kalteclabs/fg-falcon-carplay-unit/README.md

KALTEC · FG FALCON CARPLAY UNIT

### A CarPlay screen in your FG or FGX FALCON, in about 10 minutes. Pull out the tissue box, clip in the bracket, add any single-DIN head unit to your centre console!
**Jump to:** [FREE BRACKET FILE](#download-the-bracket) · [GET STARTED](#get-started) · [KITS](#kits)

---

<p align="center">
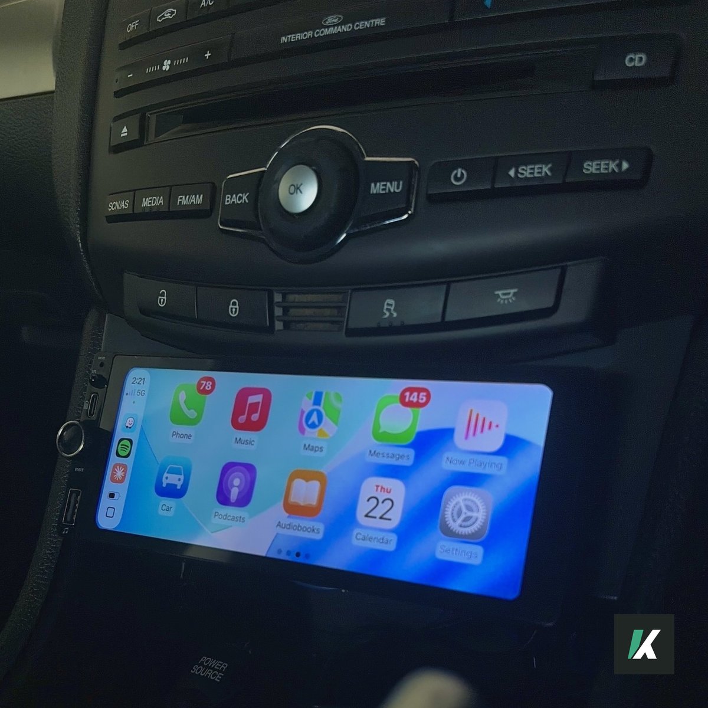
[picture p1: images/fg-installed.jpg]
CarPlay head unit fitted in the FG Falcon tissue box slot
  
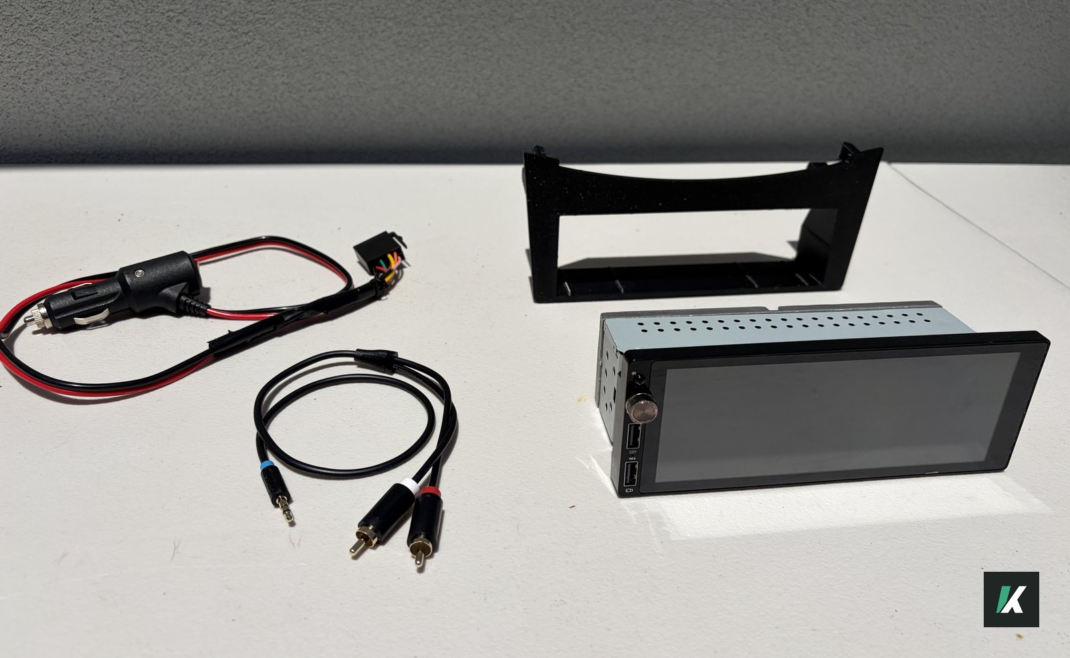
[picture p2: images/kit-parts-cig.jpg]
Head unit, bracket, cigarette plug lead and RCA cable
  
</p>

<p align="center"></p>

The CarPlay head unit takes the place of the tissue box under your factory stereo. The factory stereo stays, and the sound plays through your Falcon's own speakers via the AUX. **No splicing or cutting into any of your car's wiring!**

The parts cost about **A$65–75**, most of that being the head unit. The bracket print file is **free** from KALTEC, and the full install guide and parts list are open source too.

It's easy to remove, and the bracket can be used for an additional radio instead, if you're running aftermarket speakers or a subwoofer.

> [!TIP]
> Don't want to build it? KALTEC kits come with everything ready to plug in. Preorder a KALTEC kit for A$100: [kalteclabs@gmail.com](mailto:kalteclabs@gmail.com).

---

## DOWNLOAD THE BRACKET

<p align="center">
  
  
  
</p>

The bracket replaces your tissue box and holds any single-DIN head unit. No screws: it clips in with the two plastic clips off the tissue box. The print file is free, in three formats:

| Where | What you get | Best for |
| --- | --- | --- |
| **MakerWorld** | Print profile with the settings below | Bambu Lab printers, print straight from Bambu Studio or Handy |
| **Printables** | STL | Any printer and slicer |
| **GitHub** | STL, 3MF and STEP | Every file, including the STEP for changing the design |

**Printing it:** PETG or ASA, never PLA (it sags in a hot car). 0.2 mm layers, 4 walls, 5 top and bottom layers, 40% gyroid infill, no supports, front face down. About 3 hours and 89 g of PETG on a Bambu Lab H2S.

**[Free bracket page →](free-bracket.md)** for the full print settings, PETG vs ASA, and fitting tips.

---

## GET STARTED

1. **[Install guide](install-guide.md):** step-by-step guide to build it yourself. Pick how you'd like to power the unit:

| | Cigarette lighter | Fuse box |
| --- | --- | --- |
| **Time** | About 10 minutes | About 30–45 minutes |
| **How** | Plug the unit into the cigarette lighter | Two fuse taps in the fuse box, cable hidden behind a panel |

2. **[Parts list](parts-list.md):** everything you need, with links and prices.
3. **[Free bracket](free-bracket.md):** the 3D print files and print settings, free to download.

<p align="center">
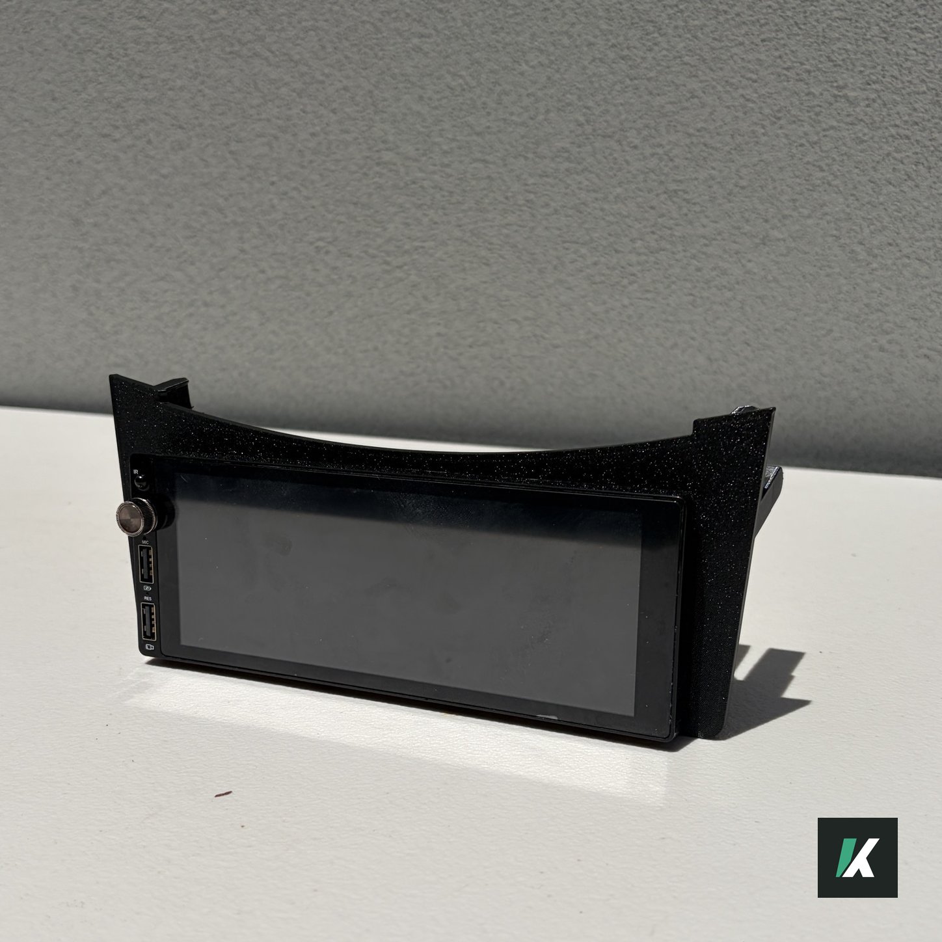
[picture p3: images/unit-in-bracket-front.jpg]
CarPlay head unit pressed into the KALTEC FG bracket
  
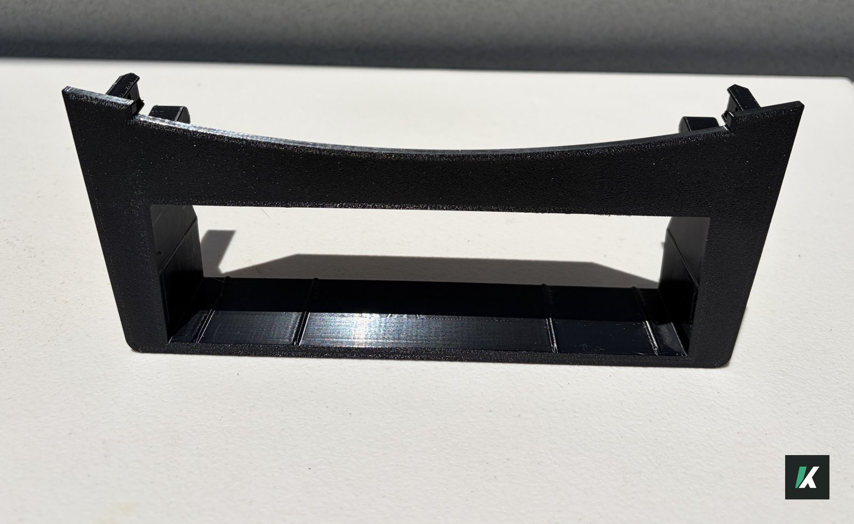
[picture p4: images/bracket.jpg]
The KALTEC FG bracket on its own
  
</p>

---

## FITMENT

Supports all FGs except the FPV line.

| Model | Sedan | Ute |
|---|:---:|:---:|
| XR6 | Y | Y |
| XR8 | Y | Y |
| G6E | Y | Y |
| G6 | Y | Y |
| XT | Y | Y |
| FPV | N | N |

---

## KITS

KALTEC kits are for anyone without a 3D printer or who'd rather not make the power lead. Brackets come with the clips already fitted, and we ship anywhere in Australia.

Preorder a KALTEC kit for A$100: [kalteclabs@gmail.com](mailto:kalteclabs@gmail.com).

Website is coming soon (kaltec.au). Stick around for the final kits or preorder now for cheaper!

---

## WHY IT'S FREE
This started as a one-off for my own FG. Now the bracket and the full guide are open source, so any Falcon owner can fit CarPlay for the cost of the parts.

**Built by a Falcon owner, for the Falcon owners who still drive and appreciate this piece of Australian engineering. No more overpriced aftermarket head unit swaps that cost an arm and a leg**

Star this repo to support the project and to support a local 21-year-old engineer, this will also help reach more falcon owners!

---

## LICENCE

Free to build, change, share and sell. See [LICENSE.md](LICENSE.md):

- **Bracket files (STL, 3MF, STEP):** [CERN-OHL-S-2.0](https://ohwr.org/cern_ohl_s_v2.txt)
- **Guides and images:** [CC BY-SA 4.0](https://creativecommons.org/licenses/by-sa/4.0/legalcode)

Credit KALTEC with a link to this repo, and release anything you change under the same licence.

**KALTEC · CC BY-SA 4.0 · [github.com/kalteclabs/fg-falcon-carplay-unit](https://github.com/kalteclabs/fg-falcon-carplay-unit)**

FG FALCON SINGLE-DIN Head Unit README v1.4
