kalteclabs/fg-falcon-carplay-unit/free-bracket.md

KALTEC · FG FALCON CARPLAY UNIT · FREE BRACKET

### Free 3D print files for all FG and FGX FALCONS. A bracket that replaces your tissue box and holds a single-DIN head unit, for a CarPlay or aftermarket stereo, all provided free by KALTEC.

**Jump to:** [Download](#download) · [Print settings](#print-settings)

---

<p align="center">
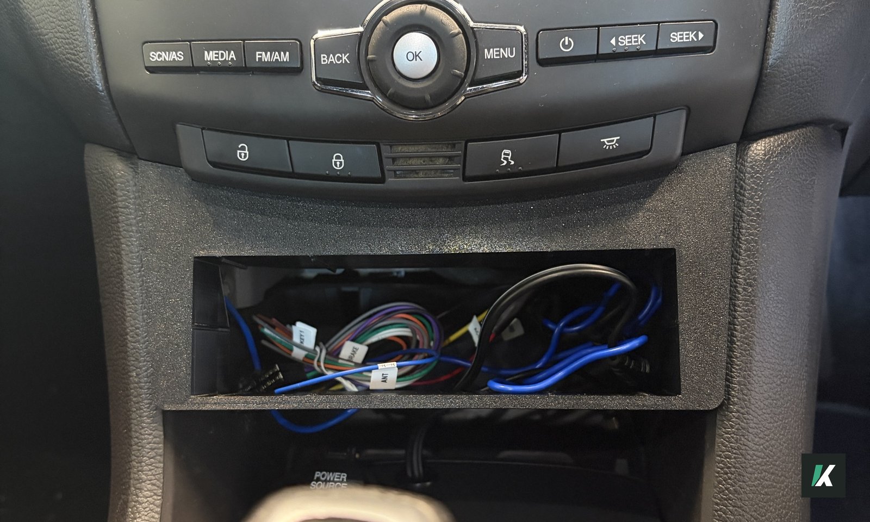
[picture p5: images/bracket-in-slot.jpg]
The bracket fitted in the car, no head unit
  
  The KALTEC FG bracket on its own
</p>

> [!TIP]
> Don't have a 3D printer? Preorder a KALTEC kit for A$100: [kalteclabs@gmail.com](mailto:kalteclabs@gmail.com).

---

## DOWNLOAD
### The bracket replaces your tissue box (the tray in the dash). No screws: pull out the tray, pop in the bracket, and a single-DIN head unit takes its place.

Removing the tray and fitting the bracket is covered step by step in the [install guide](install-guide.md#1-take-out-the-tissue-box).

<p align="center">
  
  
  
</p>

**[Spin the 3D preview](bracket/kaltec-fg-bracket-v1.0.stl)** to see it before you print.

| Download | Link | Best for |
| --- | --- | --- |
| **MakerWorld** | [Download on MakerWorld](https://makerworld.com/en/models/3575689-fg-falcon-carplay-bracket-single-din-head-unit) | Bambu Lab printers: print profile included, print straight from Bambu Studio or Handy |
| **Printables** | [Download on Printables](https://www.printables.com/model/1907338-ford-falcon-carplay-bracket-single-din-head-unit-t) | Any printer and slicer |
| **GitHub** | [3MF](https://github.com/kalteclabs/fg-falcon-carplay-unit/releases/latest/download/kaltec-fg-bracket-v1.0.3mf) · [STL](https://github.com/kalteclabs/fg-falcon-carplay-unit/releases/latest/download/kaltec-fg-bracket-v1.0.stl) · [STEP](https://github.com/kalteclabs/fg-falcon-carplay-unit/releases/latest/download/kaltec-fg-bracket-v1.0.step) | Every file, including the STEP for changing the design |

**Bambu Lab printer?** Grab the [Bambu Studio project](bracket/kaltec-fg-bracket-v1.0.3mf): it has the PETG settings below already set. Open it, check your plate and filament, and print.

---

## PRINT SETTINGS

Tested on a Bambu Lab H2S with a 0.4 mm nozzle. Start from your printer's standard profile for the filament, then set these.

<table>
<tr>
<td>

| Setting | Recommended |
| --- | --- |
| Supports | Off |
| Layer height | 0.2 mm |
| Walls | 4 |
| Top / bottom layers | 5 / 5 |
| Infill | 40% gyroid |
| Nozzle temp | 245 °C |
| Print time | 3 h 4 min |
| Filament used | 89 g |

</td>
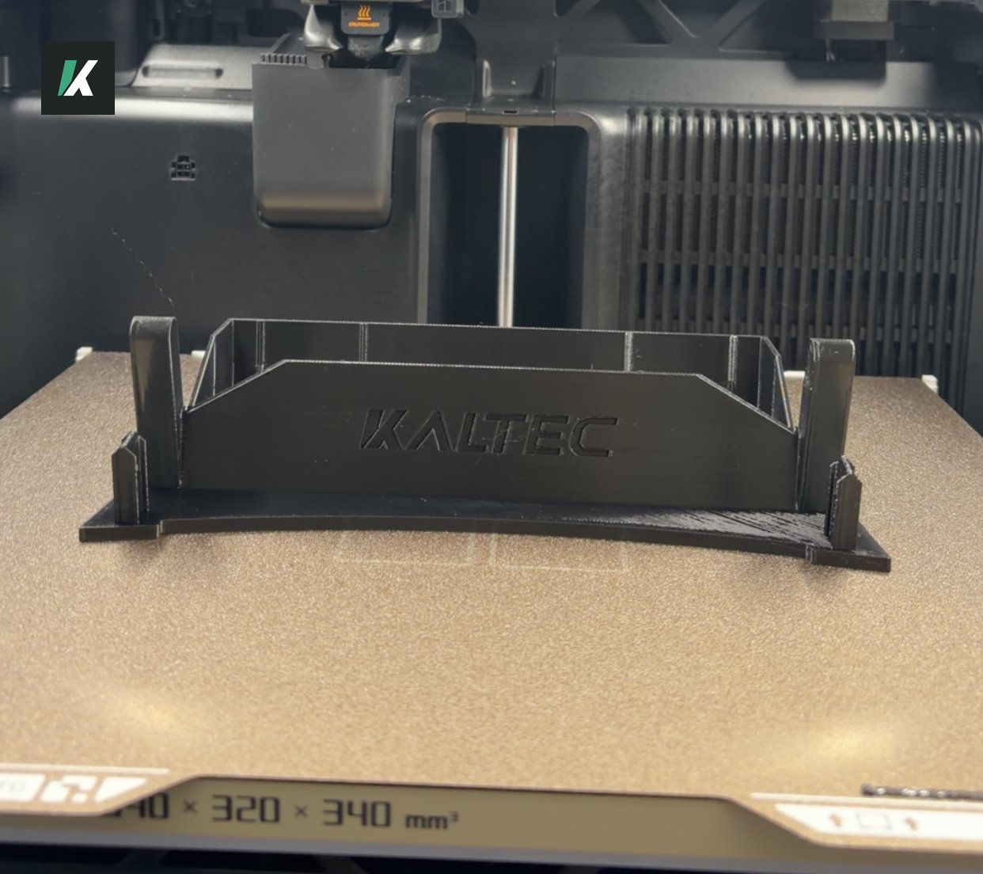
[picture p6: images/bracket-print-bed.jpg]
The bracket on the print bed, front face down, KALTEC lettering on the back
<td></td>
</tr>
</table>

---

## FILAMENT

Print in **PETG or ASA**.

| PETG | ASA |
| --- | --- |
| Cheaper, easier to print and get better finish | More heat resistant, and resists warping |
| Prints on any printer | Closer to the factory dash plastic |
| More than enough if your car is tinted or parks in the shade | Ready to fit straight off the printer |

> [!WARNING]
> **Don't print it in PLA.** It softens in a hot car and the bracket sags.
> If your car sits in the sun or has no tint, use ASA, or give PETG a [UV clear coat](parts-list.md#optional).

---

## FITMENT

<p align="center">
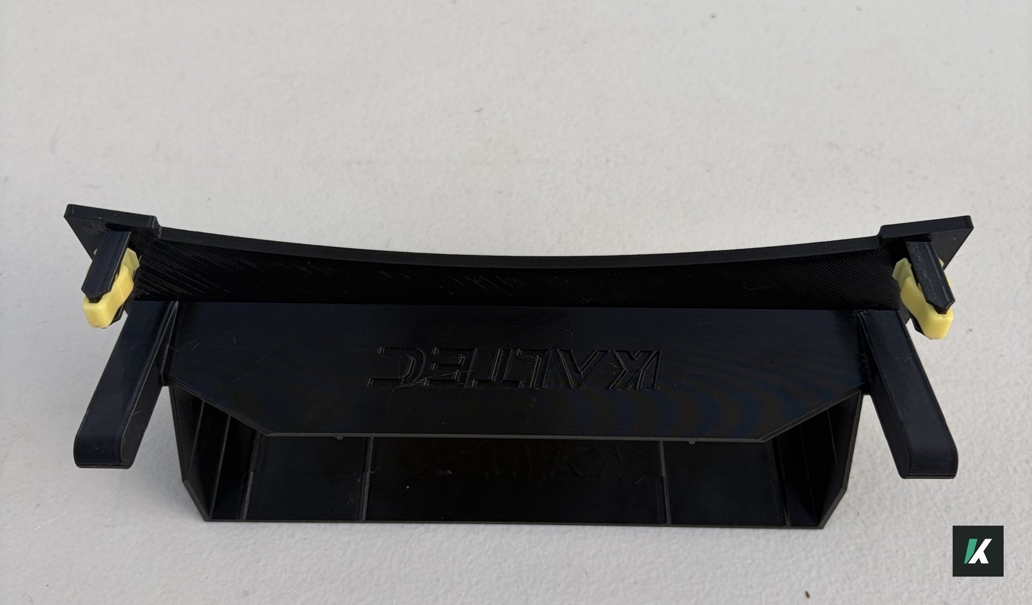
[picture p7: images/clips-on-tabs.jpg]
Yellow clips fitted on both bracket tabs
  
  Head unit pressed into the bracket
</p>

Supports all FGs except the FPV line.

| Model | Sedan | Ute |
|---|:---:|:---:|
| XR6 | Y | Y |
| XR8 | Y | Y |
| G6E | Y | Y |
| G6 | Y | Y |
| XT | Y | Y |
| FPV | N | N |

**Too tight?** That's intended. Ensure the metal sleeve your unit came with is removed, then lightly sand the small ridges inside the 3D printed bracket, until the unit pushes in snug.

**Too loose?** Add thin inserts or tape inside the bracket. The unit should be tight, with no wiggle.

**Odd-sized head unit?** Open the STEP file and adjust the bracket to suit. The bracket design is free to build, change and sell under [CERN-OHL-S-2.0](LICENSE.md). If you share a changed version, credit KALTEC with a link to this repo and release it under the same licence.

Ready? Fit it with the [install guide](install-guide.md).

---

**KALTEC · CC BY-SA 4.0 · [github.com/kalteclabs/fg-falcon-carplay-unit](https://github.com/kalteclabs/fg-falcon-carplay-unit)**

This guide and its photos are free to share and adapt under CC BY-SA 4.0: credit KALTEC with a link to this repo. The bracket design is free to build, change and sell under CERN-OHL-S-2.0.

FG FALCON SINGLE-DIN Head Unit Free Bracket v1.4
