kalteclabs/fg-falcon-carplay-unit/parts-list.md

KALTEC · FG FALCON CARPLAY UNIT · PARTS LIST

### Parts list for all FG and FGX FALCONS. Every link, price and item you need to build your Falcon unit as cheaply and easily as possible, all provided free by KALTEC.

**Jump to:** [Parts](#parts) · [Fuse box layout](#fuse-box-layout) · [Troubleshooting](#troubleshooting)

---
### You'll need a head unit, and the free bracket, then follow the steps to power it!
<p align="center">
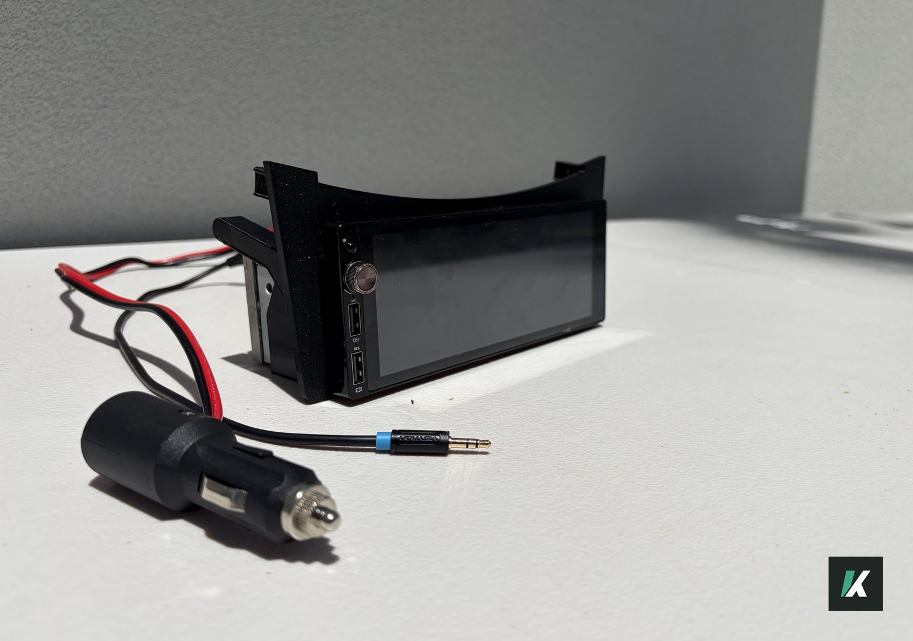
[picture p8: images/parts-together.jpg]
Head unit in the bracket with the cigarette plug lead and AUX cable
  
  Head unit, bracket, cigarette plug lead and RCA cable laid out
</p>

---

## FREE BRACKET 3D PRINT FILE
### This replaces your tissue box (the tray in the dash), with no screws required!

> [!TIP]
> Don't have a 3D printer? KALTEC brackets and full kits make this build as easy as possible. Preorder a KALTEC kit for A$100: [kalteclabs@gmail.com](mailto:kalteclabs@gmail.com).

<p align="center">
  The KALTEC FG bracket, printed in black
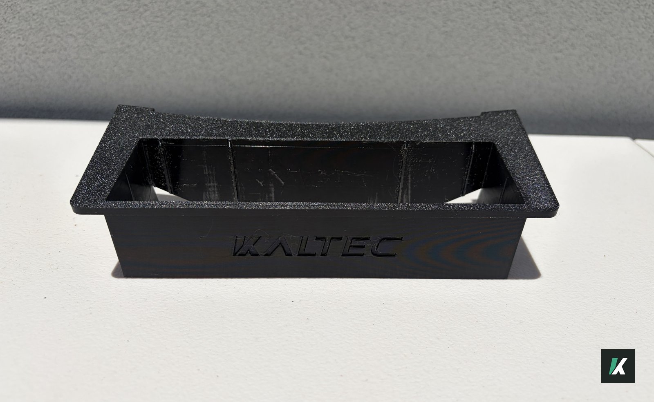
[picture p9: images/bracket-rear.jpg]
Rear of the KALTEC FG bracket, with the recessed KALTEC lettering
  
</p>

**The bracket is provided free by KALTEC.** Download the 3D print file from [MakerWorld](https://makerworld.com/en/models/3575689-fg-falcon-carplay-bracket-single-din-head-unit), [Printables](https://www.printables.com/model/1907338-ford-falcon-carplay-bracket-single-din-head-unit-t) or the [free bracket page](free-bracket.md) and print it. The right print settings are on that page too.

Print in **PETG or ASA**. If your car sits in the sun or has no tint, protect the bracket with a UV clear coat: see [optional parts](#optional).

<p align="center">The bracket fitted in the car, without the head unit</p>

---

## PARTS

Building this yourself costs about **A$65–75**, and most of that price is the head unit itself (about $50).
Prices are in AUD. The links are the exact parts I used. Copy the **search term** into AliExpress for the current cheapest options.

Any head unit works, as long as it's **single DIN**: the standard 18 × 5 cm size, not double DIN. 

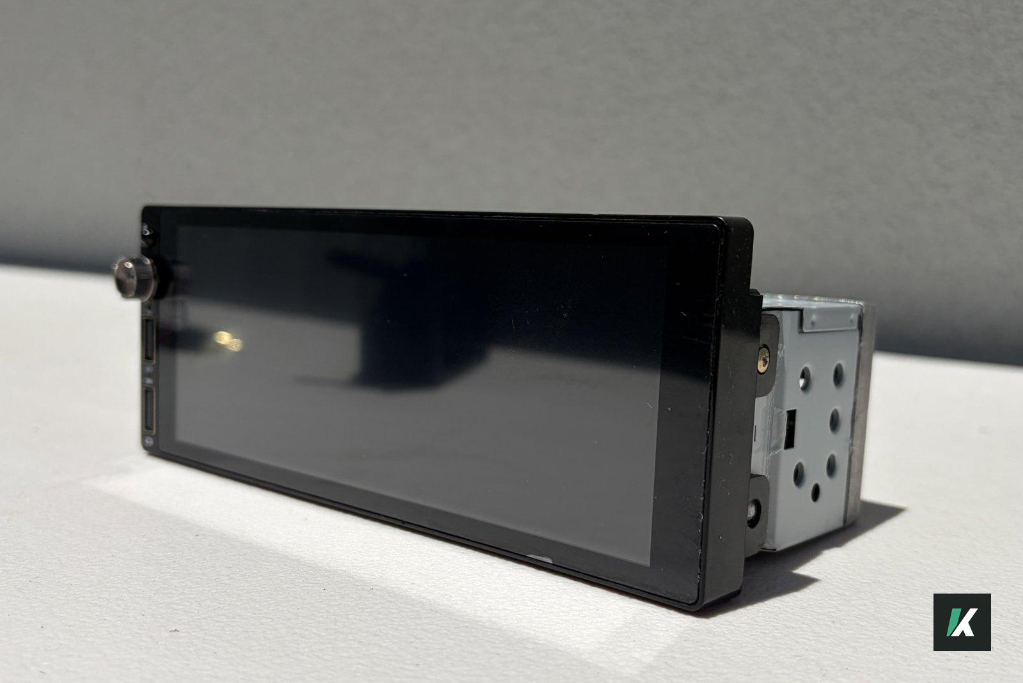
[picture p10: images/head-unit.jpg]
Single-DIN CarPlay head unit


> [!NOTE]
> Wireless CarPlay is worth the extra few dollars, but wired units work exactly the same for this project. _I've bought and tested both!_

| Part | Price | About | Links to buy | Search term |
| --- | --- | --- | --- | --- |
| Single-DIN head unit | $50 | Any single-DIN unit works. Some come with an antenna, reverse camera or GPS module. | [AliExpress](https://www.aliexpress.com/item/1005007025889615.html) | 'Single din head unit' · 'Single din CarPlay' |
| 2 plastic Ford interior clips | $4 for 50 | Reuse the pair off your tissue box. Only buy if yours break. KALTEC brackets and kits include spares. | [AliExpress](https://www.aliexpress.com/item/32989988241.html) | 'HE08 clips' · 'Ford interior trim clips' |
| Audio cable, 2× RCA to 3.5 mm | $4 | Runs sound from the head unit's RCA outs into the Falcon's AUX, through the factory speakers. | [AliExpress](https://www.aliexpress.com/item/1326108747.html) · [Bunnings](https://www.bunnings.com.au/antsig-1-5m-3-5mm-aux-to-rca-cable_p0286420) | 'RCA to 3.5 mm' · 'RCA to AUX cable' |
| Heat-shrink tubing | $15 for 24 (a few dollars on AliExpress) | Covers every join and the unused wire ends so nothing shorts. | [Supercheap](https://www.supercheapauto.com.au/p/sca-sca-heat-shrink-tubing---assorted-3.2-6.4mm-24-piece/120316.html) | 'Heat shrink tubing assorted' |

### PLUG-IN POWER (CIGARETTE LIGHTER)

The easy one. A cigarette plug lead joins to the head unit's power plug and plugs into the factory outlet. Nothing in the car gets touched.

| Part | Price | About | Links to buy | Search term |
| --- | --- | --- | --- | --- |
| Cigarette plug lead | $3 for 2 | Plugs into the factory outlet under the slot. Get one with a **10A fuse** and **0.75 mm² or thicker** wire. | [AliExpress](https://www.aliexpress.com/item/1005007145876029.html) | 'Fused cigarette plug 10A' · 'Cigarette lighter male plug' |

**Plug-in total: about A$65**

### FUSE BOX POWER

Hides the cables by taking power from the fuse box.

Nothing in the car gets cut or spliced. Instead, we extend the head unit's two power wires to reach the fuse box, then connect and push the fuse taps into place, once we've identified which ones to tap into.

| Part | Price | About | Links to buy | Search term |
| --- | --- | --- | --- | --- |
| 2 fuse taps, mini blade | $5 for 5 | Holds the car's original fuse plus a second one for the head unit, so it gets power without cutting any wires. | [AliExpress](https://www.aliexpress.com/item/1005010560224519.html) · [Supercheap](https://www.supercheapauto.com.au/p/sca-sca-add-a-circuit-twin-mini-fuse/726757.html) | 'Mini blade fuse tap' · 'Add a circuit mini' |
| Mini blade fuses: one **10A** and one **5A** | $4 for 6 | **10A** in the ALWAYS ON tap, **5A** in the KEY ON tap. Don't rely on the fuses that come with the taps. This pack has both. | [Supercheap](https://www.supercheapauto.com.au/p/sca-sca-automotive-fuses-mini-blade-assorted-6-pack/726752.html) | 'Mini blade fuse 10A' · 'Mini blade fuse 5A' |
| Wire | $10 for 4 m | Extends the power wires to the fuse box. Use **0.75 mm² or thicker**. Supercheap's "4 mm" cable is sized by outside diameter; its core is about 1.85 mm². | [AliExpress](https://www.aliexpress.com/item/1005009017260144.html) · [Supercheap](https://www.supercheapauto.com.au/p/sca-sca-automotive-cable-single-core-15a-4mm-x-4m-blue/376702.html) | '0.75 mm² automotive wire' · '18 AWG automotive wire' |

**Fuse box total: about A$75**

### OPTIONAL

| Part | Price | About | Links to buy | Search term |
| --- | --- | --- | --- | --- |
| Spare power harness | $4 | A spare of the head unit's power plug (generic ISO lead), in case you need a new one. | [AliExpress](https://www.aliexpress.com/item/1005006782766797.html) | 'Car stereo ISO cable male' · 'ISO wiring harness male plug' |
| UV clear coat | $28 | Protects the bracket from UV if your windows aren't tinted. | [Supercheap](https://www.supercheapauto.com.au/p/mtn-mtn-pro-high-heat-clear-coat-400ml-spray-paint/688225.html) | 'UV clear coat spray' · 'High heat clear coat' |

---

### TOOLS

- Wire strippers
- A heat gun or lighter, for the heat-shrink
- **Fuse box only:** crimpers, for the fuse taps, and a socket for the M7 ground bolt
- Optional: a plastic trim tool
- Optional: a multimeter or test light

**You'll also need** a KALTEC bracket (preorder at [kalteclabs@gmail.com](mailto:kalteclabs@gmail.com)), or a 3D printer + PETG or ASA filament to print your own.

Once you have all the items needed, **star this repo** and fit the unit in your Falcon with the [install guide](install-guide.md).

<p align="center">Tools and extras: crimper/stripper, lighter, heat-shrink, 2 fuse taps, a 10 A and a 5 A fuse, extra wire</p>

---

### FUSE BOX LAYOUT

**If you're powering the unit via the cigarette port, you can skip this.** The steps for finding your fuses are in the [install guide](install-guide.md#75-pick-your-fuses-and-connect-the-taps).

Layouts are similar across FG models and years, but not identical. Always check your own car first: the layout is usually printed inside the fuse box lid, or check the owner's manual.

**If you can't find yours, I've made a basic layout that suits most FG Falcons.** The highlighted fuses are good ones to tap. On my FG, I used fuse **15** for BATTERY (always on) and fuse **21** for ACC (key on).

<p align="center">General FG fuse box layout, with fuse 15 (always on) and fuse 21 (key on) highlighted</p>

---

## TROUBLESHOOTING

### NO POWER

- **Both** BATTERY (yellow) and ACC (red) need power for the unit to turn on. Check both joins.
- Only **one** ground is needed: the wire your manual labels GND.
- Check the fuse on the back of the head unit.
- **Plug-in:** push the cig plug all the way in, and check the fuse in its tip (unscrew the ring). Test the outlet with a phone charger with the key on.
- **Fuse box:** check the tapped fuse is live with a meter, and that the ground bolt is tight.
- Unit turns on, then cuts out by itself? The blue **ANT** wire may be touching power. Tape it off on its own.

---

### LOSES THE CLOCK AND SETTINGS WHEN THE CAR TURNS OFF

- **Plug-in:** that's normal. BATTERY and ACC are joined, so the unit starts fresh each time. Use the [fuse box route](install-guide.md#7-fuse-box-power) if you want them kept.
- **Fuse box:** BATTERY (yellow) and ACC (red) are swapped, or both are on key-on fuses. BATTERY must go on an **always-on** fuse.

---

### NO SOUND

- The audio cable is in **MIC IN** instead of the RCA outs. Move it to **L-OUT / R-OUT** (red and white).
- The factory stereo isn't on AUX. Press <kbd>MEDIA</kbd> until it shows AUX.
- Check the cable is pushed fully into the AUX port, and turn up the volume on the head unit as well as the car.

---

### FLAT BATTERY, OR THE UNIT STAYS ON WITH THE KEY OUT

- **Fuse box:** ACC (red) is on an always-on fuse. Move it to a key-on fuse. Key off, the unit must switch off.
- **Plug-in:** if your cigarette lighter stays live with the key out, purchase a cig plug with an ON/OFF switch, or use the [fuse box route](install-guide.md#7-fuse-box-power).

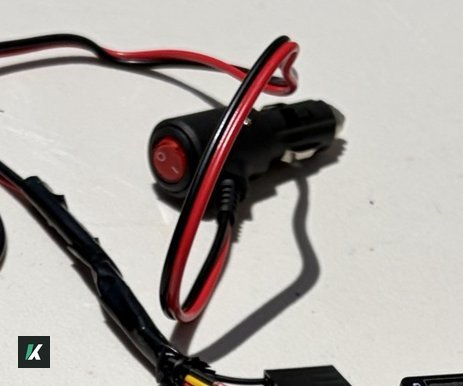
[picture p11: images/cig-plug-switch.jpg]
Cigarette lighter plug with an ON/OFF switch


---

### BRACKET IS LOOSE OR THE CLIPS WON'T SEAT

- Check both clips are pushed all the way onto the tabs. Cracked or worn clips? Replace them, they're cheap ([parts](#parts)).
- Wiring bunched up behind the unit can push the bracket out. Tuck it to the sides so nothing gets pinched.
- Push the bracket in evenly, both sides at once, until both clips click.
- Sometimes the console edges interfere with the bracket. Flex them out with your hands to seat it.

<p align="center">The plastic sides of the console slot highlighted: flex them out if the bracket catches</p>

---

### HEAD UNIT IS TOO TIGHT OR TOO TALL FOR THE BRACKET

- Take off the metal sleeve if your unit came with one. It isn't used.
- Make sure you've printed the latest STL from the [free bracket page](free-bracket.md#download), at 100% scale.
- Lightly sand the ridges inside the bracket, evenly on both sides, until it presses in.
- Unit too **loose** instead? Add thin inserts or tape inside the bracket so it fits tight.
- Odd-sized unit? Adjust the [STEP file](free-bracket.md#fitment) to fit. Any single-DIN unit with the same power plug works.

---

### CARPLAY WON'T CONNECT

- **Wired:** use a good data cable (some cheap ones only charge), plugged into the unit's USB port.
- **Wireless:** Bluetooth and Wi-Fi both on. Forget the car on your phone and pair again.
- Check CarPlay is allowed on your phone: Settings → General → CarPlay.
- Restart the head unit: key off, wait 10 seconds, key on.

---

### NO RADIO ON THE HEAD UNIT

- The head unit needs its own [car radio antenna](https://www.aliexpress.com/item/1005005732812892.html) plugged into the **ANT** socket on the back. The Falcon's antenna stays on the factory stereo. Search AliExpress for 'car radio antenna stick on' if yours didn't come with one.
- The blue **ANT** wire is not the antenna. Keep it taped off.
- Don't need it? The factory radio still works as normal.

---

**KALTEC · CC BY-SA 4.0 · [github.com/kalteclabs/fg-falcon-carplay-unit](https://github.com/kalteclabs/fg-falcon-carplay-unit)**

This guide and its photos are free to share and adapt under CC BY-SA 4.0: credit KALTEC with a link to this repo. The bracket design is free to build, change and sell under CERN-OHL-S-2.0.

FG FALCON SINGLE-DIN Head Unit Parts List v1.3
