kalteclabs/fg-falcon-carplay-unit/bracket/kaltec-fg-bracket-v1.0.step

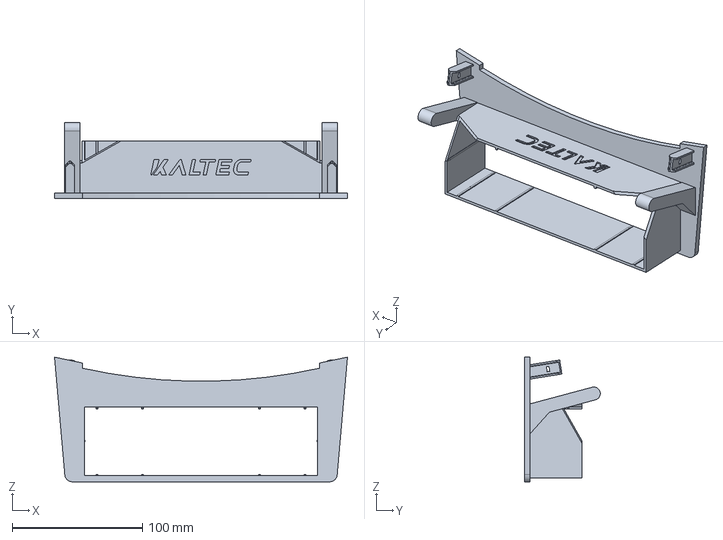
[picture p12: CAD file, 2026-11-04]
bracket/kaltec-fg-bracket-v1.0.step
225.0 x 58.1 x 95.8 mm
