kalteclabs/fg-falcon-carplay-unit/(list of files, cad)

Other CAD files:
bracket/kaltec-fg-bracket-v1.0.3mf
bracket/kaltec-fg-bracket-v1.0.stl
