kalteclabs/fg-falcon-carplay-unit/install-guide.md

KALTEC · FG FALCON CARPLAY UNIT · INSTALL GUIDE

### Install guide for all FG and FGX FALCONS to build and install your own CarPlay unit for about A$65–75, all provided free by KALTEC.

**Jump to:** [Steps](#1-take-out-the-tissue-box) · [Parts list](parts-list.md) · [Troubleshooting](parts-list.md#troubleshooting)

<p align="center"></p>

---

### THERE ARE TWO WAYS TO POWER THE CARPLAY HEAD UNIT

**Power with the cigarette lighter (about 10 minutes):** the easiest way. Plug the unit into the cigarette lighter and have a full plug-and-play setup within minutes. *It's easily removable as well, just don't throw out your tissue box!*

<p align="center">
  Head unit, bracket, cigarette plug lead and RCA cable for the plug-in install
  The same parts assembled: head unit in the bracket with the plug lead and AUX cable
</p>

**Power with the fuse box (about 30–45 minutes):** attach two fuse taps in your fuse box and hide the cable for a more integrated setup. Keeps the clock and settings, and frees up the cigarette lighter. *A little more time-consuming, as you need to take an interior panel off to hide the cable.*

<sub>IMAGE COMING SOON: head unit with fuse box setup.</sub>

> [!TIP]
> If you buy a KALTEC kit, everything is provided, so you just pop your old tray out and plug this in. Preorder a KALTEC kit for A$100: [kalteclabs@gmail.com](mailto:kalteclabs@gmail.com). Otherwise, the DIY setup needs a power lead, the 3D printed bracket ([file provided free](free-bracket.md)) and your head unit of choice. Follow the steps below to get up and running.

---

## YOU NEED

Everything needed is in the [parts list](parts-list.md#parts).

- [ ] The bracket to replace the tissue box, 3D print file _provided free from KALTEC_ on [MakerWorld](https://makerworld.com/en/models/3575689-fg-falcon-carplay-bracket-single-din-head-unit), [Printables](https://www.printables.com/model/1907338-ford-falcon-carplay-bracket-single-din-head-unit-t) or the [free bracket page](free-bracket.md)
- [ ] A single-DIN head unit, _any will work!_
- [ ] An RCA to 3.5 mm audio cable
- [ ] Heat-shrink tubing

Either:

- [ ] **Cigarette lighter power:** a cigarette male plug lead
- [ ] **Fuse box power:** 2 mini blade fuse taps, a 10A and a 5A mini blade fuse, about 2 m of extra wire

## 1. TAKE OUT THE TISSUE BOX

No tools needed. Grip the bottom lip and pull it firmly towards you. It's held by two clips and pops straight out.

> [!TIP]
> Keep the tissue box. It clips back in if you ever remove the bracket.

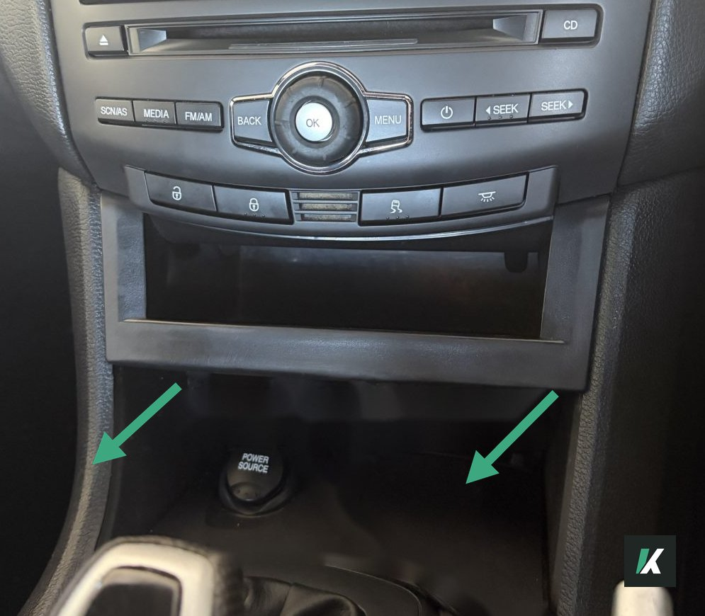
[picture p13: images/tissue-box-in-dash.jpg]
FG Falcon tissue box in the centre console, with arrows showing where to pull from


## 2. PUT THE CLIPS ON THE BRACKET

> [!TIP]
> Skip this step if you got a pre-made bracket or kit, as KALTEC brackets come with the clips already fitted.

Slide the two yellow plastic clips off the tissue box and onto the bracket's two tabs, one on each.

_The clips are fragile when you flex them off the tissue box. If one breaks, a 50 pack costs a few dollars: see the [parts list](parts-list.md#parts)._

<p align="center">
  Yellow clips fitted on both bracket tabs
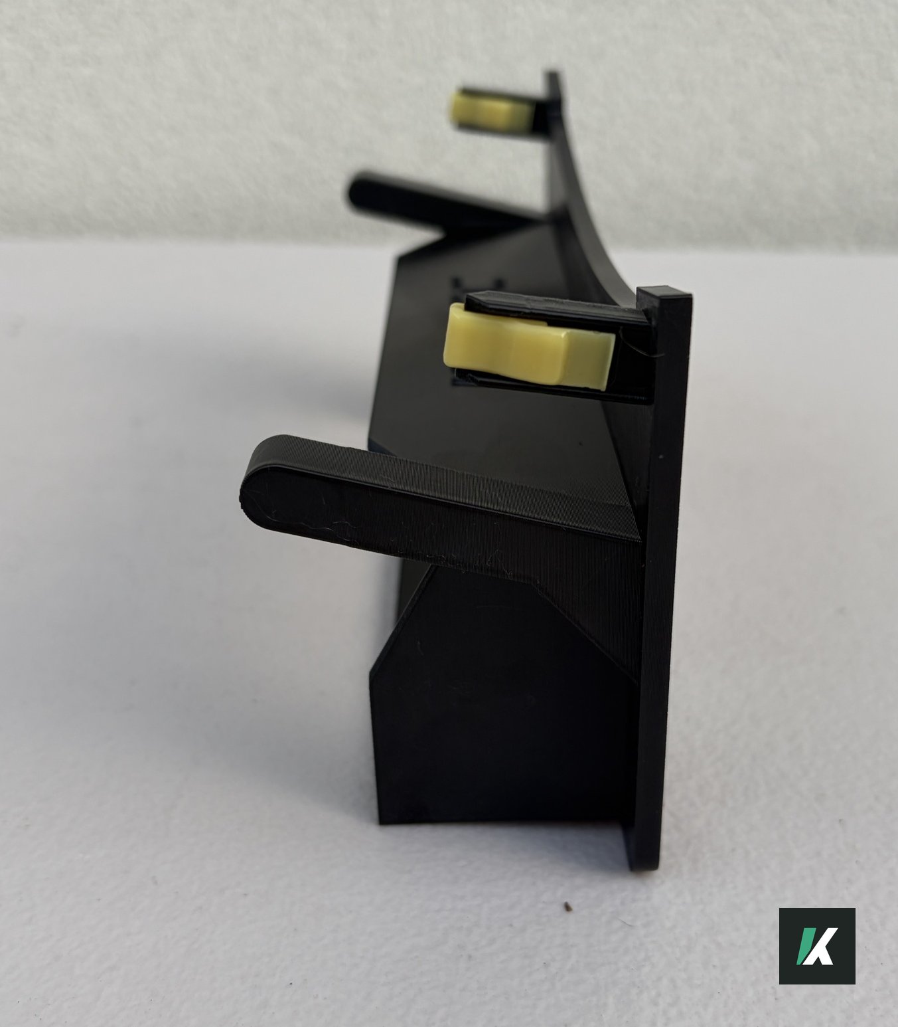
[picture p14: images/clips-on-tabs-side.jpg]
Side view of a clip on the bracket tab
  
</p>

## 3. MAKE THE CIGARETTE POWER LEAD

**If you're powering the unit via the fuse box**, skip this step and go to [step 7](#7-fuse-box-power).

> [!IMPORTANT]
> **Got a kit from KALTEC?** Skip this step, connect your power cable and go straight to [step 4](#4-plug-in).

You're joining the head unit's power plug to a cigarette plug lead. Only three wires get used.

### 3.1 FIND THE POWER PLUG

Your head unit comes with two plugs. The speaker plug has 8 wires in pairs, solid and striped. You don't need it, because the sound goes through the RCA cable instead. Set it aside.

Use the power plug. It's the one with the red, yellow and black wires.

<p align="center">The speaker plug next to the power plug, with the power plug marked as the one to use</p>

### 3.2 FIND YOUR THREE WIRES

| Wire | Usually | Goes to |
| --- | --- | --- |
| BATTERY / B+ 12V | Yellow | The cigarette plug's **red (+)**, joined with ACC |
| ACC | Red | The cigarette plug's **red (+)**, joined with BATTERY |
| GND | Black | The cigarette plug's **black (−)** |

> [!NOTE]
> Go by the **label** in your manual, because colours change between head units.

<p align="center">The manual's power plug wiring, with BATTERY, ACC and GND highlighted</p>

### 3.3 CUT, STRIP AND TWIST

Cut all the other wires on the power plug short and heat-shrink the ends. Ensure no wires touch.

<p align="center">The five unused wires cut short and heat-shrunk, red, yellow and black left long</p>

Strip about 1 cm off the ends of BATTERY (yellow), ACC (red) and GND (black).

<p align="center">1 cm stripped off the ends of red, yellow and black</p>

Twist the bare ends of BATTERY and ACC together tightly, so they share the same power.

<p align="center">Red and yellow twisted into one end, black kept separate</p>

### 3.4 CONNECT TO THE CIGARETTE PLUG LEAD

Join the wires and heat-shrink each join:

- The twisted BATTERY + ACC goes to the cigarette plug's red (+) wire.
- GND goes to the cigarette plug's black (−) wire.

Unscrew the tip of the cigarette plug and check there's a **10A** fuse inside. If it's a different value, swap it for a 10A.

<p align="center">Red and yellow joined to the cig lead's red (+), black joined to black (−), each join heat-shrunk</p>

### 3.5 PLUG THE LEAD INTO THE HEAD UNIT

Before you plug anything in, check:

- No bare wire shows anywhere on the lead.
- The wire can reach from the cigarette plug to the back of the head unit.

<p align="center">The finished plug-in lead: power plug to cigarette plug</p>

Push the power plug into the matching socket on the back of the head unit until it clicks. It only fits one way round.

<!-- images/install/03-9-lead-into-unit.svg -->
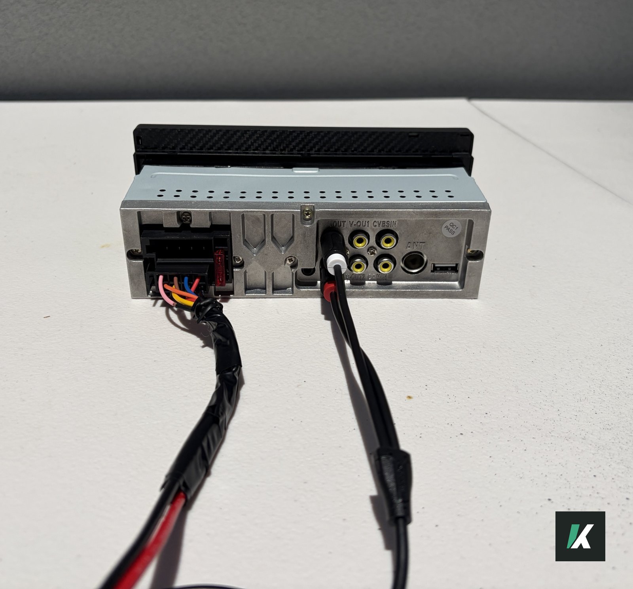
[picture p15: images/power-plug-in.jpg]
Power plug and RCA leads plugged into the back of the head unit


## 4. PLUG IN

1. Plug the audio cable into the red and white RCA outs (**L-OUT / R-OUT**, not MIC IN), and the other end into the car's AUX. *Most Falcons have the AUX right next to the cigarette lighter.*
2. If your head unit came with a reverse camera or radio antenna, plug them in.
3. If you haven't already, plug in your head unit's power cable.

<p align="center">
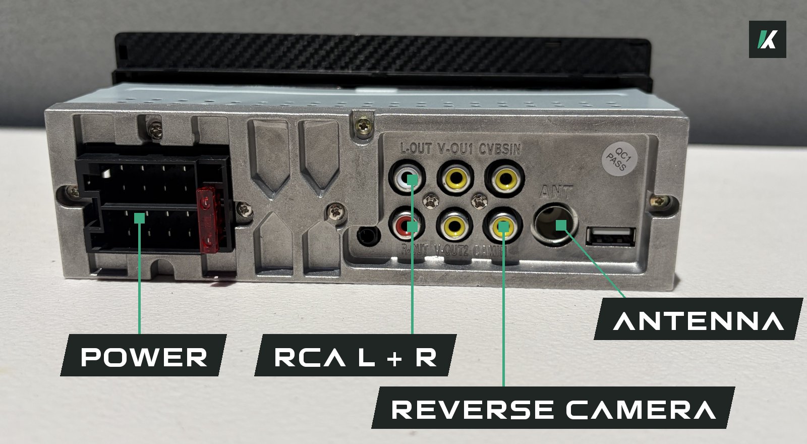
[picture p16: images/back-ports-labelled.jpg]
Back of the head unit with POWER, RCA L and R, REVERSE CAMERA and ANTENNA labelled
  
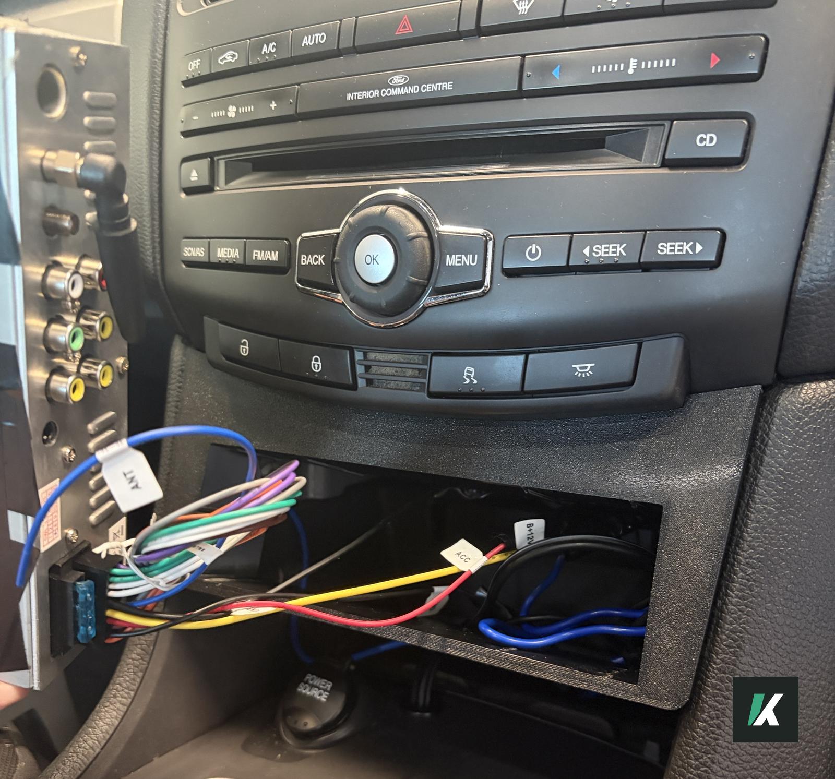
[picture p17: images/plugging-in-at-slot.jpg]
Head unit held at the slot with the power plug and antenna lead plugged in
  
</p>

## 5. SECURE IT

If your unit came with a metal sleeve, remove it first. Then press the head unit into the bracket from the front until it sits flush. It's a tight press fit, so push firmly and evenly.

<p align="center">
  Head unit pressed flush into the bracket
  The head unit and bracket fitted in the car, powered on
</p>

1. Make sure the yellow clips are on your bracket.
2. Tuck the wiring behind the head unit so nothing gets pinched.
3. Line the bracket up with the console and push it in evenly until it clicks securely into place.

## 6. TEST IT

1. Turn the key on. The head unit starts up. On the factory stereo, press <kbd>MEDIA</kbd> to cycle through the sources until it shows AUX.
2. Connect your phone and play something. Check maps, radio and anything else your unit has.
3. **Fuse box:** turn the key off. The unit must switch off. Turn it back on: the clock and settings should still be there. Then clip the interior panel back on.

> [!TIP]
> Something not right? The bracket pops straight back out. See [troubleshooting](parts-list.md#troubleshooting).

<p align="center">Press MEDIA on the factory stereo until the display shows AUX</p>

**Done.** The head unit turns on and off with the key. Support the project by **starring this repo**!

---

## 7. FUSE BOX POWER

> [!TIP]
> **Bought a ready-made fuse box lead from KALTEC?** Skip 7.1 and start at [7.2](#72-connect-the-ground).

Your head unit comes with a power plug, and we only need 3 of its wires. The two power wires get extended to reach the fuse box and plug into it with fuse taps. The ground wire goes to a bolt in the slot. Check your manual for the right wires. They're usually:

| Wire | Usually | Goes to |
| --- | --- | --- |
| BATTERY / B+ 12V | Yellow | A fuse that's **always on**. Keeps the clock and settings |
| ACC | Red | A fuse that's **on with the key only**. Turns the unit on and off |
| GND | Black | A bolt inside the tissue box slot |

---

### 7.1 MAKE THE LEAD

Use the wiring plug that came with your head unit. Join wires the same way as in [step 3.4](#34-connect-to-the-cigarette-plug-lead).

1. Join 1 m of wire to **BATTERY** and 1 m to **ACC**. Join about 20 cm to **GND**.
2. Crimp the end of BATTERY into one fuse tap's connector and label it **ALWAYS ON – 10A**.
3. Crimp the end of ACC into the other fuse tap's connector and label it **KEY ON – 5A**.
4. Strip about 2 cm off the end of GND, so it can wrap under the bolt.
5. Cut all the other wires on the power plug short and heat-shrink the ends. Ensure no wires touch.

<p align="center">The finished fuse box lead: BATTERY to the ALWAYS ON 10A tap, ACC to the KEY ON 5A tap, short GND</p>

---

### 7.2 CONNECT THE GROUND

With the tissue box out, you can see two factory bolts inside the slot. Either one works. Undo one (it's an M7 bolt), wrap the bare GND wire clockwise under the washer, and tighten it back down. Give the wire a tug to check it's held tight. Leave the power plug sitting in the slot.

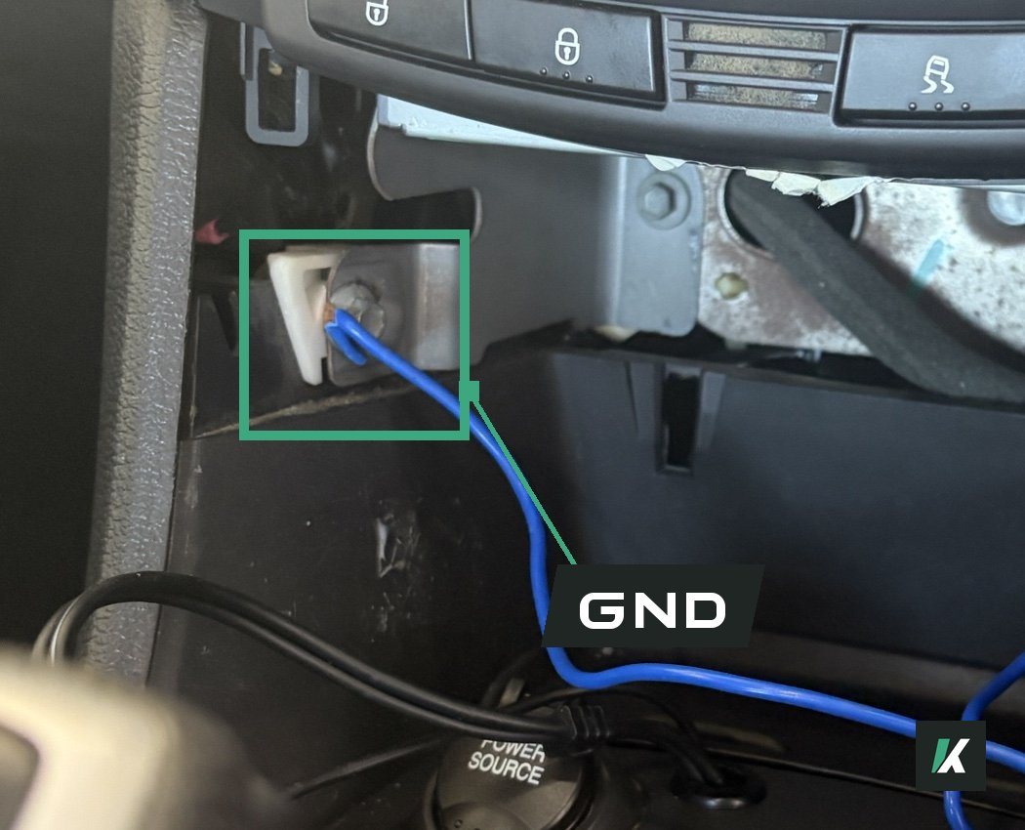
[picture p18: images/ground-wire-slot-bolt.jpg]
Ground wire fixed under the left slot bolt


---

### 7.3 FIND THE FUSE BOX

Take the key out and turn the lights off first.

It's under the dash in the driver's footwell, to the right of the steering column. Pull the cover off to see the fuses.

<p align="center">
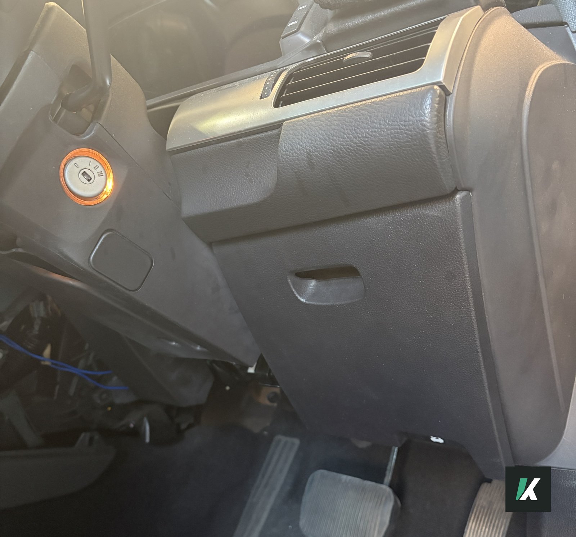
[picture p19: images/fuse-panel-on.jpg]
Fuse box cover on, under the dash in the driver's footwell
  
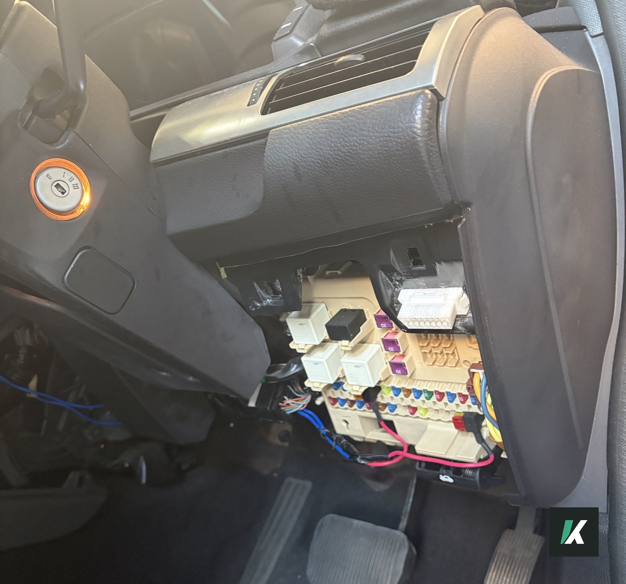
[picture p20: images/fuse-panel-off.jpg]
Fuse box cover off, fuses exposed
  
</p>

---

### 7.4 ROUTE THE WIRES

1. Pop off the plastic panel on the driver's side of the centre console, below the slot. Use a trim tool, or pull firmly from the corners.

   <p align="center">
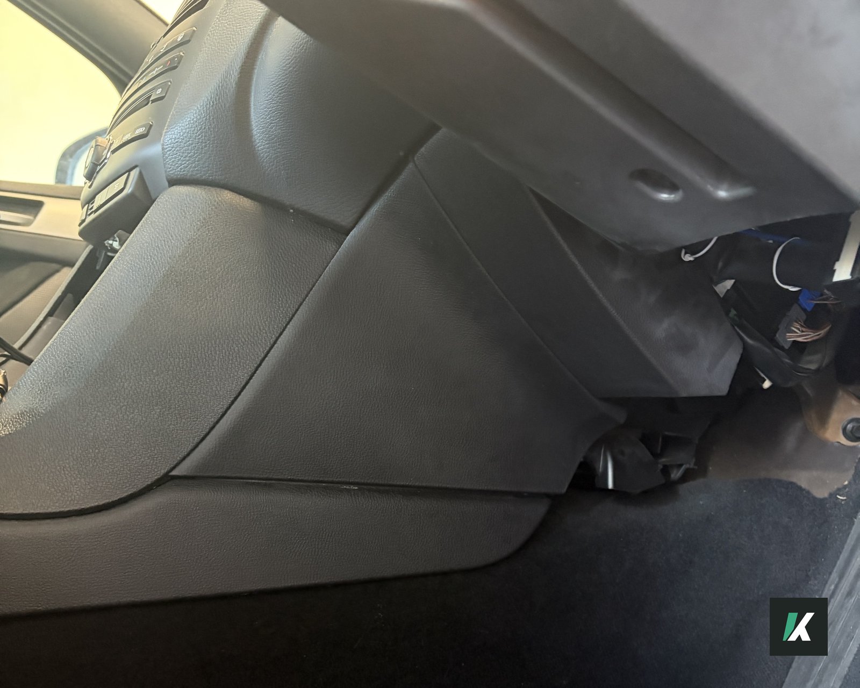
[picture p21: images/console-panel-on.jpg]
Driver's side console panel in place
     
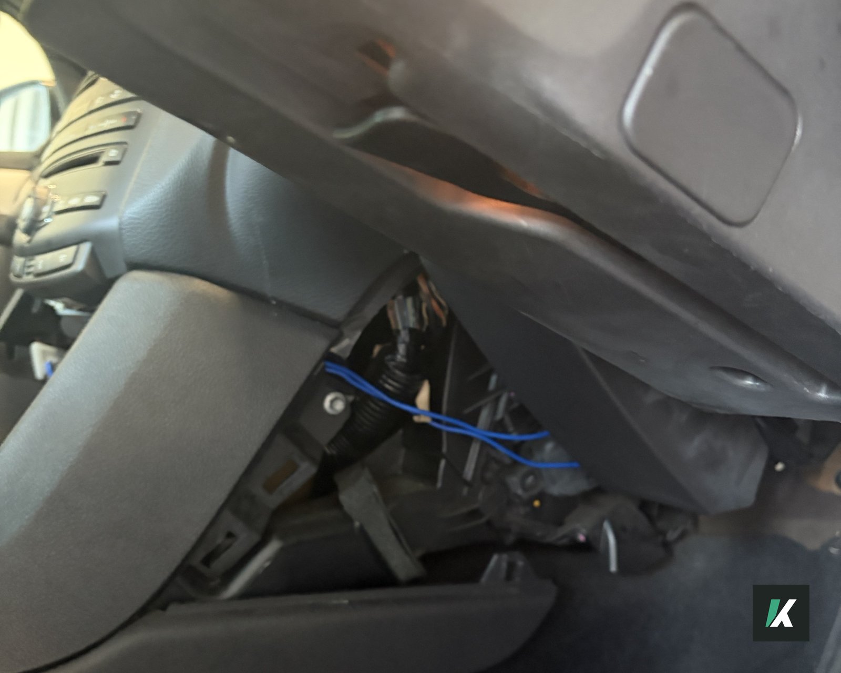
[picture p22: images/console-panel-off.jpg]
Console panel off, showing the space behind it
     
   </p>

2. Run BATTERY and ACC down behind the panel, then behind the steering column to the fuse box, so nothing shows.
3. Leave the panel off until you've tested in [step 6](#6-test-it).

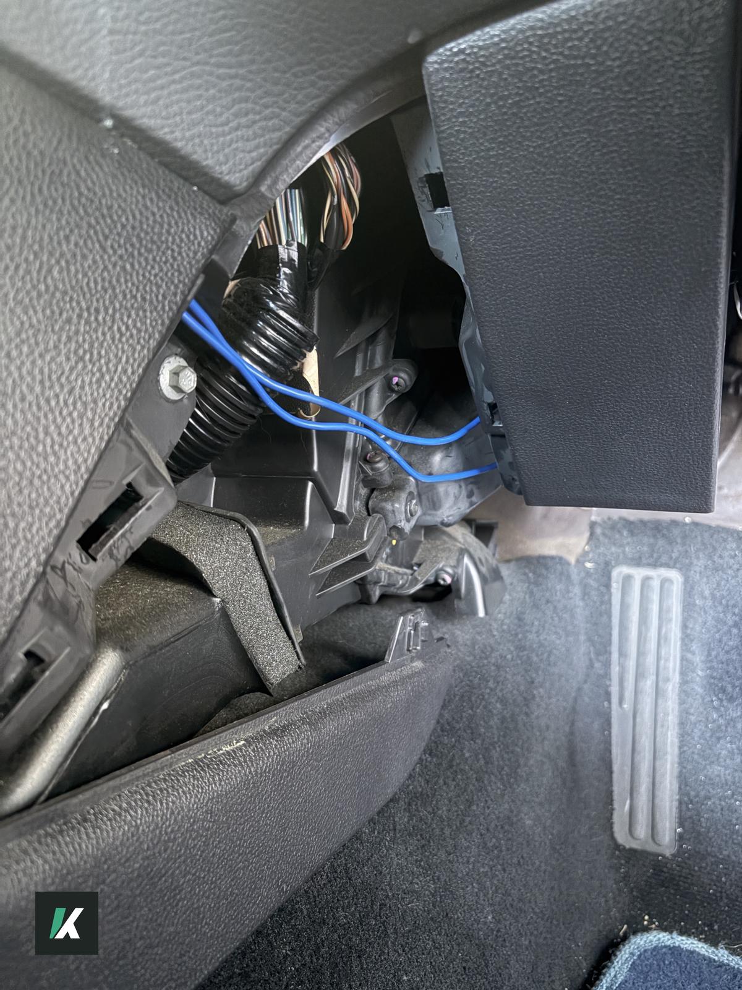
[picture p23: images/wires-routed-to-fuse-box.jpg]
Wires routed behind the console panel and steering column


---

### 7.5 PICK YOUR FUSES AND CONNECT THE TAPS

> [!TIP]
> Never put ACC on an always-on fuse, or the unit never switches off and flattens your battery. Don't tap airbag (SRS), ABS, engine (PCM) or fuel pump fuses.

> [!TIP]
> Not sure which fuse is which? A test light or multimeter shows you: an always-on fuse is live with the key out, a key-on fuse is only live with the key on.

1. Find your layout. It's usually printed inside the fuse box lid, and it's always in the owner's manual. Stuck? See the [fuse box layout](parts-list.md#fuse-box-layout).
2. Pick two fuses for non-critical accessories, like interior lights or the power outlets: one **always on** for BATTERY, one **on with the key only** for ACC. *On my FG, I used fuse **15** for BATTERY and fuse **21** for ACC. Check yours first, as layouts differ between years.*
3. Pull out each fuse you picked. Put it in its tap's **front** slot, exactly as it was, and never swap it for a bigger one.
4. Put a new fuse in each tap's **back** slot: **10A** in the ALWAYS ON (BATTERY) tap, and **5A** in the KEY ON (ACC) tap. Don't use the fuses that came with your taps unless they're these values.
5. Push the ALWAYS ON tap into the always-on fuse's slot, and the KEY ON tap into the key-on fuse's slot.

<p align="center">Load the fuse tap: the car's fuse in the front slot, the new fuse in the back slot</p>

<p align="center">The ALWAYS ON tap in slot 15 and the KEY ON tap in slot 21</p>

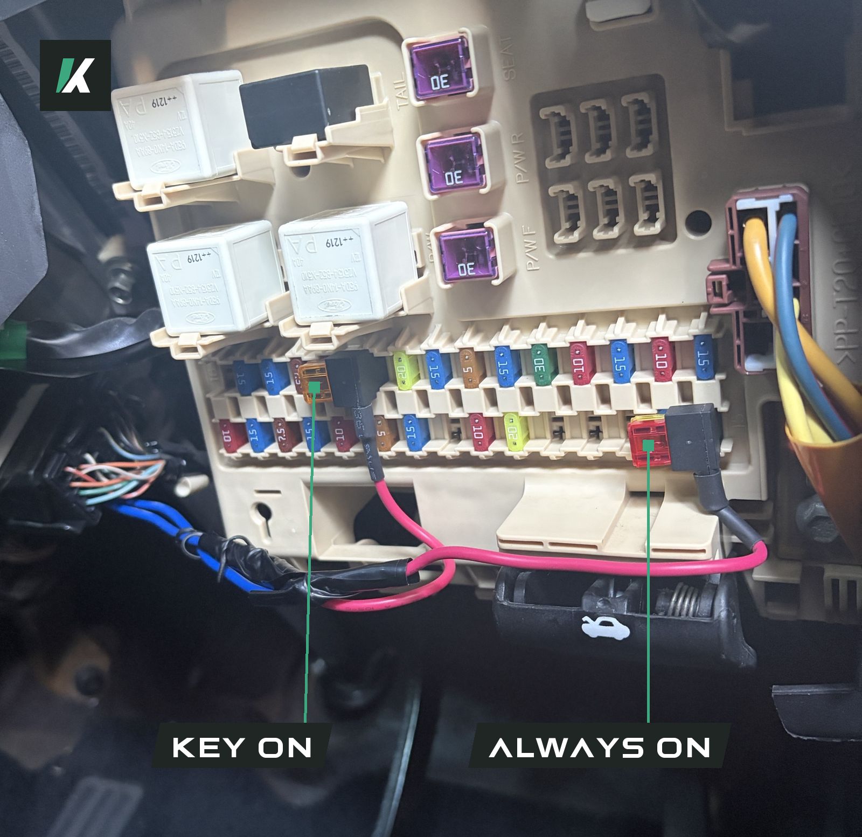
[picture p24: images/fuse-taps-installed.jpg]
Fuse taps in the fuse box, labelled KEY ON and ALWAYS ON


> [!TIP]
> New to fuse taps? It's the same method as fitting a dash cam, tapping into your car's power without cutting any cables. *I watched these videos to learn how to do it. I have no electrical or mechanical experience. It's super easy, needs no special tools and is really cheap!*
>
> - [Fitting a fuse tap (dash cam)](https://www.youtube.com/watch?v=Hj4f70pEXC4)
> - [Fuse tap walkthrough](https://www.youtube.com/watch?v=K2iKXj82354&t=258s)

Your power plug is now grounded, connected to the fuse box and waiting in the slot. The hard part is done! Continue to [step 4](#4-plug-in), where you plug everything into the unit and secure it to the dash.

---

**Want it on paper?** The whole guide, parts list and fuse box layout as one A4 PDF:

<p align="center"></p>

---

**KALTEC · CC BY-SA 4.0 · [github.com/kalteclabs/fg-falcon-carplay-unit](https://github.com/kalteclabs/fg-falcon-carplay-unit)**

This guide and its photos are free to share and adapt under CC BY-SA 4.0: credit KALTEC with a link to this repo. The bracket design is free to build, change and sell under CERN-OHL-S-2.0.

FG FALCON SINGLE-DIN Head Unit Install Guide v1.4
