kalteclabs/fg-falcon-carplay-unit/(commit log)

2026-10-23 Create install-guide.md
    Version 1.0 of the full build guide. Plug-in (cigarette lighter) and hardwired (fuse box) install for the FG Falcon CarPlay unit. Photos, parts list, fuse layouts and common issues to follow. No photos yet
2026-11-01 Spell out tap fuse values (10A always-on, 5A key-on) and fix fuse row in parts list
2026-11-02 Fix 7.x anchors, cig-route wiring table, fuse and wire notes, remove duplicate footer
2026-11-04 Add bracket v1.0 print files (STL, 3MF, STEP)
    [kaltec-fg-bracket-v1.0.3mf, kaltec-fg-bracket-v1.0.step, kaltec-fg-bracket-v1.0.stl]
2026-11-04 Add free bracket page v1.0
2026-11-04 Link the free bracket page from README, parts list and install guide
2026-11-04 Bracket v1.0: update to v27 model and final PETG print settings
    [kaltec-fg-bracket-v1.0.3mf, kaltec-fg-bracket-v1.0.step, kaltec-fg-bracket-v1.0.stl]
2026-11-04 Polish free bracket page and add v1.0 3MF
    [kaltec-fg-bracket-v1.0.3mf]
2026-11-05 Bracket page: PETG print time and filament, fix STEP link from parts list
2026-11-06 Add product and install photos in place of image placeholders
    Branded with the KALTEC mark. Fills README, install guide, parts list
    and free bracket placeholders; adds a rear bracket shot to the parts list.
2026-11-06 Pair photos side by side and crop the tray photo
    README hero next to the parts laid out, unit in bracket next to the bare
    bracket, install guide kit next to the assembled parts. Tray photo cropped
    with new pull arrows. Fitment notes turned into an image placeholder.
2026-11-06 Add fuse box, console panel, bracket fit, clip and plug-in photos
    Fuse box cover on/off and console panel on/off pairs, bracket in the slot
    (install, parts list, free bracket), clips on the tabs, and the unit
    plugged in at the slot for step 4.
2026-11-06 Load photos from kalteclabs/.github, add price columns and review fixes
    Images now served from .github/fg-falcon-carplay-unit/images and removed
    from this repo. Parts tables get a Price column with shorter About text.
    Bracket front/rear and step 5 photos paired. README typo fixes.
2026-11-06 Remove duplicate printer tip and use 'we' in the kits section
2026-11-07 Add Bambu Studio PETG project, final PETG settings and listing-ready download table
    4 walls, 5/5 top/bottom, 245 C, fan 40-80%, 3 h 4 min, 89 g. Download
    table now has MakerWorld, Printables and GitHub rows ready for the
    listing links.
    [kaltec-fg-bracket-v1.0-petg-bambu.3mf]
2026-11-07 Update free-bracket.md with image placement question
    Added a question about placing an image next to the table and modified the description of PETG.
2026-11-07 Bracket folder down to 3MF, STL and STEP; settings table beside the print photo
    The 3MF is now the Bambu Studio project with the PETG preset. Settings
    table renamed to Setting / Recommended with the print-bed photo beside it.
    ASA column no longer claims a better finish.
    [kaltec-fg-bracket-v1.0-petg-bambu.3mf, kaltec-fg-bracket-v1.0.3mf]
2026-11-09 Link the MakerWorld and Printables listings across the repo, tidy the README
    Download buttons on the README and free bracket page, listing links in the
    parts list and install guide, fitment in its own README section.
2026-11-09 Add step drawings, fixes and PDF links to the guides
    - Install guide v1.4 and parts list v1.3: 14 KALTEC step drawings in place of the placeholders, including loading a fuse tap and the taps in the fuse box
    - Fuse 15 for BATTERY (always on) and 21 for ACC (key on); car's fuse in the tap's front slot, new fuse in the back slot; ground is bare wire under the slot bolt, no ring terminal
    - README v1.4 and install guide: download link for the full install guide PDF
    - README, install guide, parts list and free bracket v1.4: preorder a KALTEC kit for A$120
    - Free bracket: remove the PETG/ASA image placeholder
2026-11-09 Simplify download buttons, add PDF download buttons, kits A$100
    - README and free bracket: one button each for MakerWorld, Printables and GitHub
    - README and install guide (top and end): Download the install guide (PDF) button
    - Kits preorder price A$100 on every page
2026-11-09 README: bracket download options, print settings and link to the free bracket page
